giacomogramaglia/digital_synth/README.md

# digital_synth
FPGA-based digital audio synthesizer board

Contains
- Schematics
- FPGA RTL files / Quartus II project
- KiCad project
- PCB production files
