giacomogramaglia/digital_synth/Project_Schematic.pdf

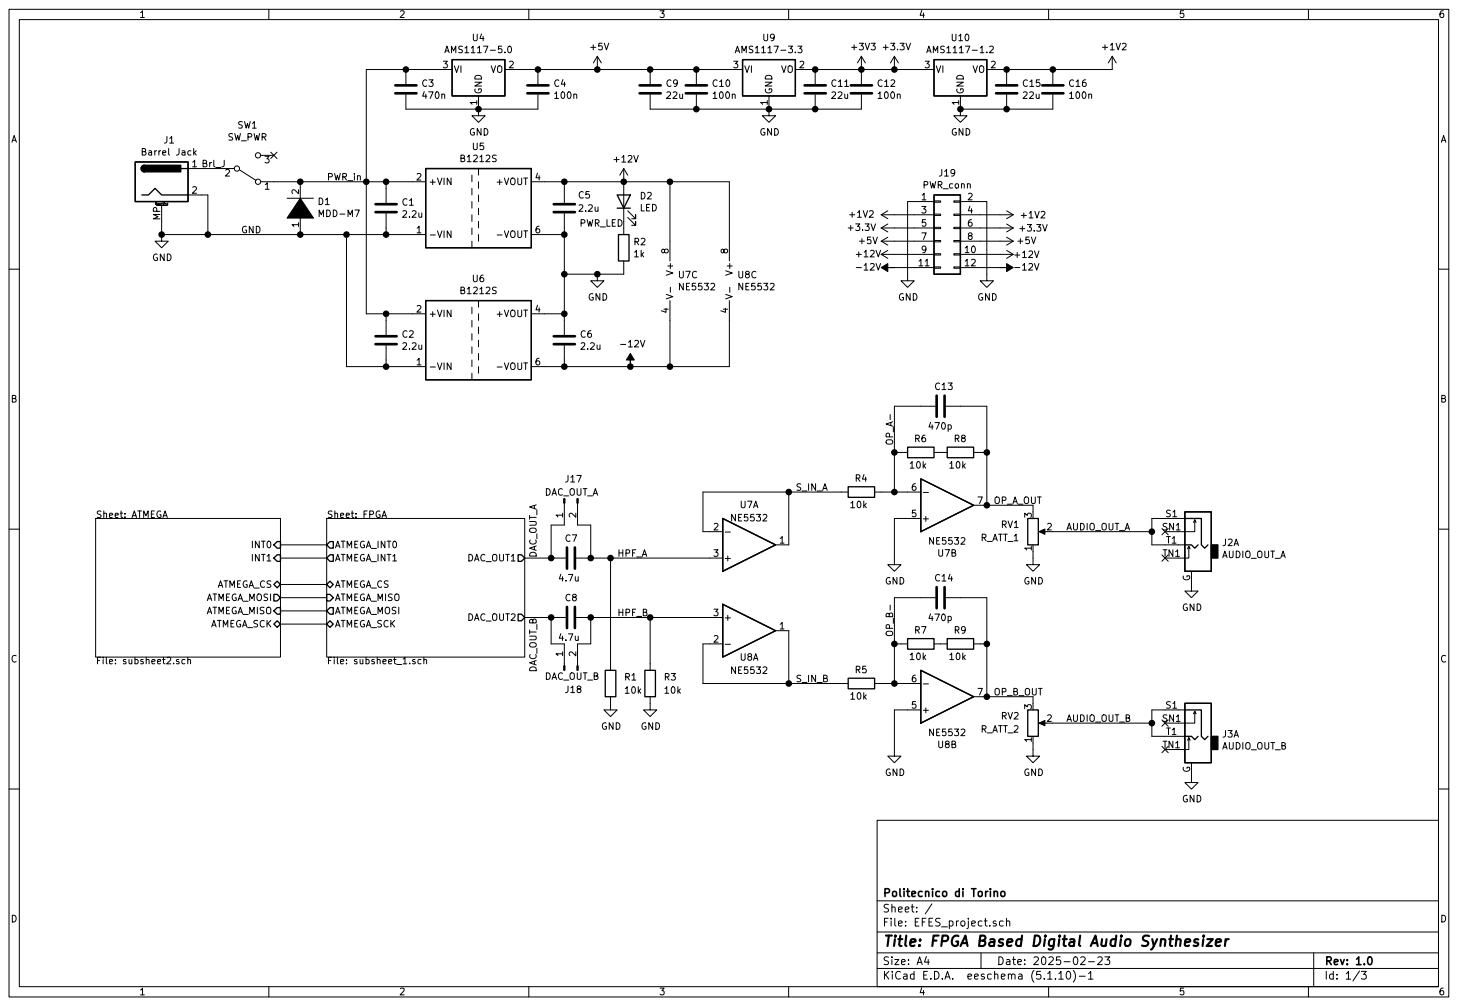
[picture p1: page 1]

File: EFES_project.sch Sheet: / Politecnico di Torino

Id: 1/3 Title: FPGA Based Digital Audio Synthesizer

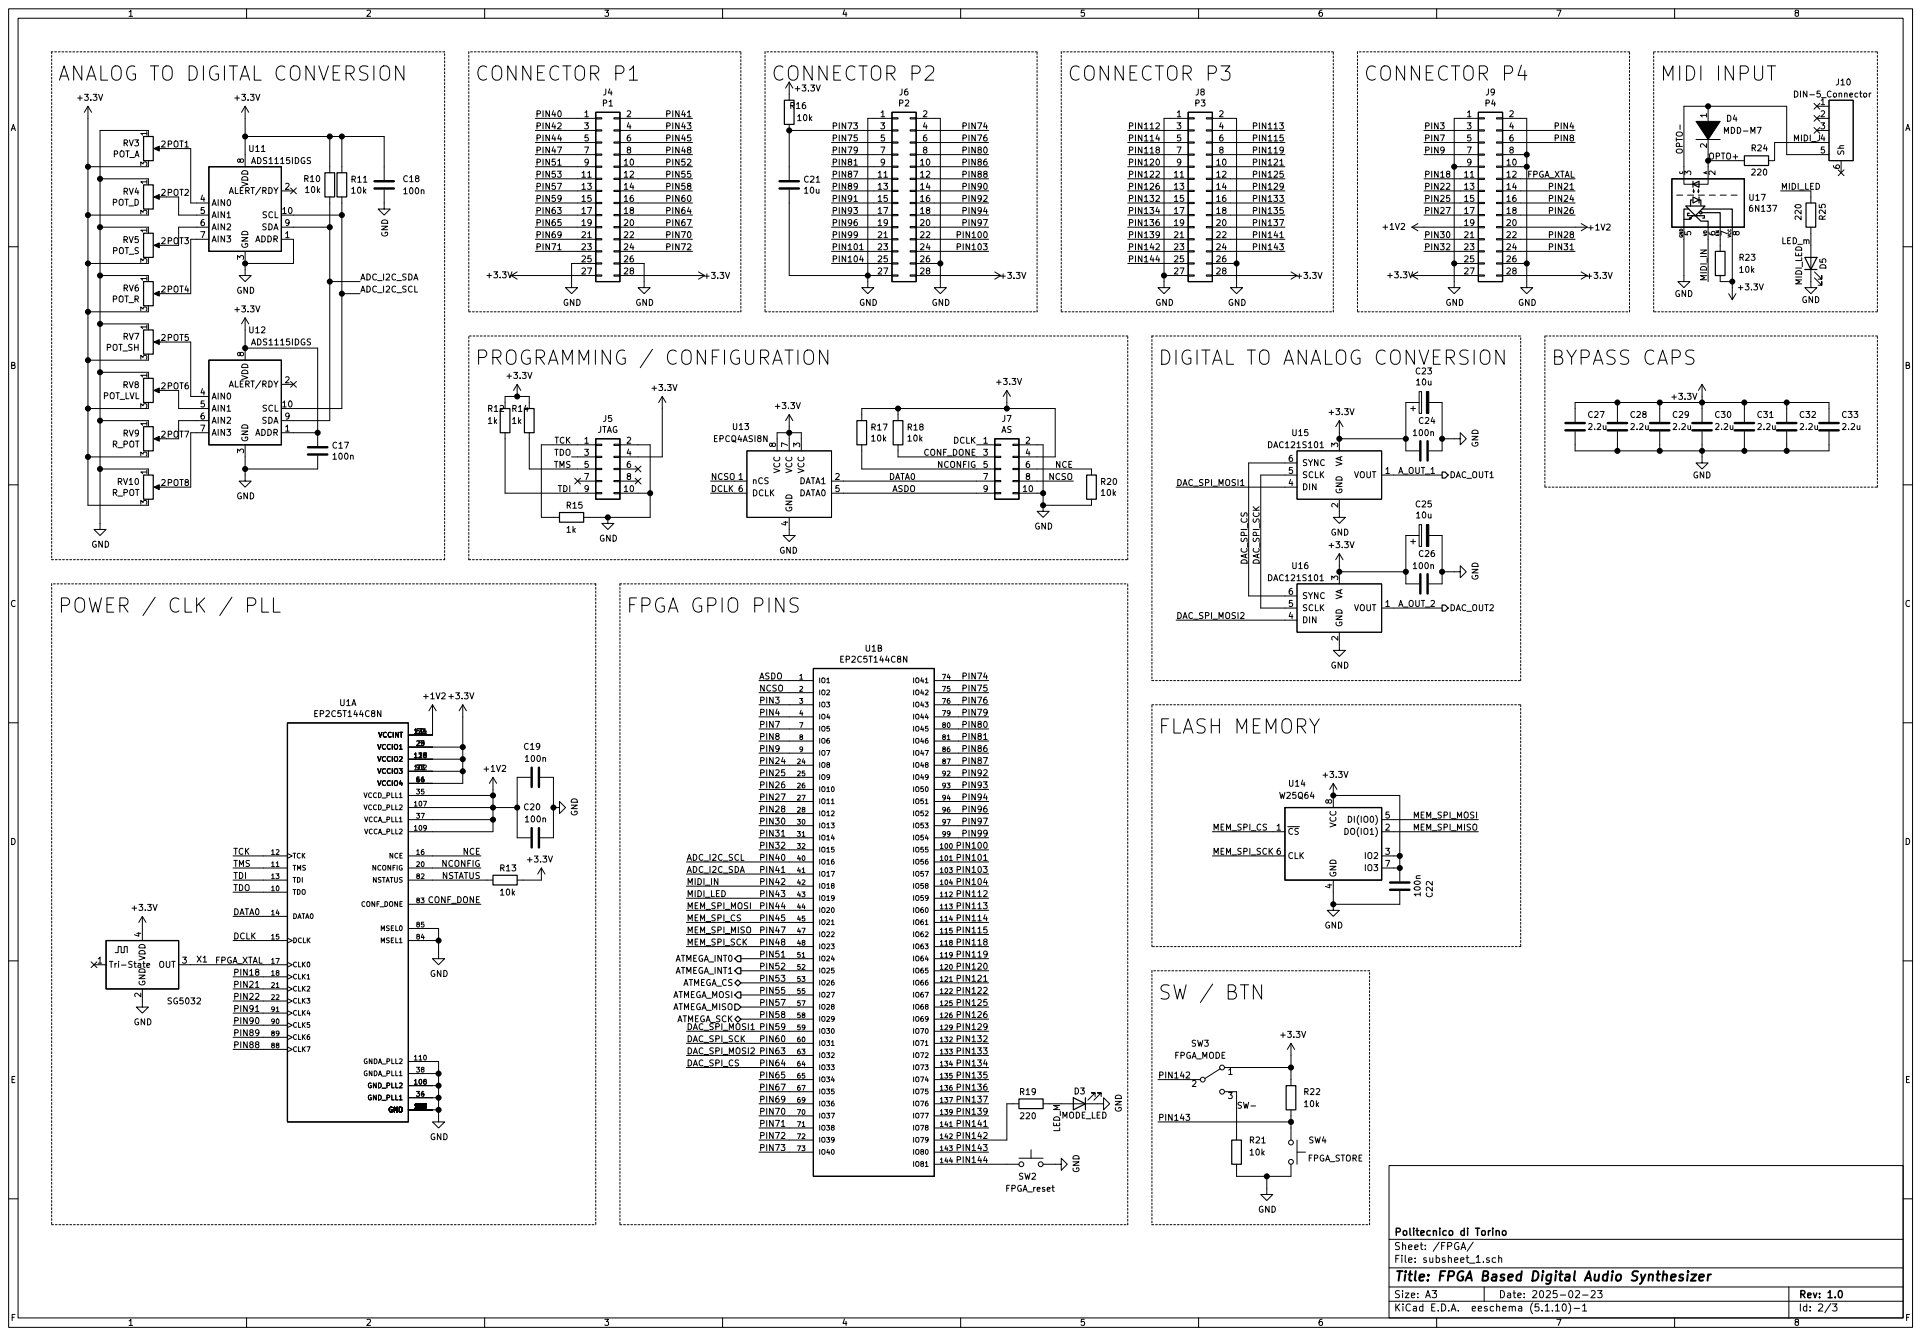
[picture p2: page 2]

PIN104 PIN76 PIN74 PIN27 ANALOG TO DIGITAL CONVERSION

DIGITAL TO ANALOG CONVERSION

3 DIN 4 SCLK 5 SYNC 6U16 DAC121S101 GND GND

File: subsheet_1.sch Sheet: /FPGA/ Politecnico di Torino

Id: 2/3 Title: FPGA Based Digital Audio Synthesizer

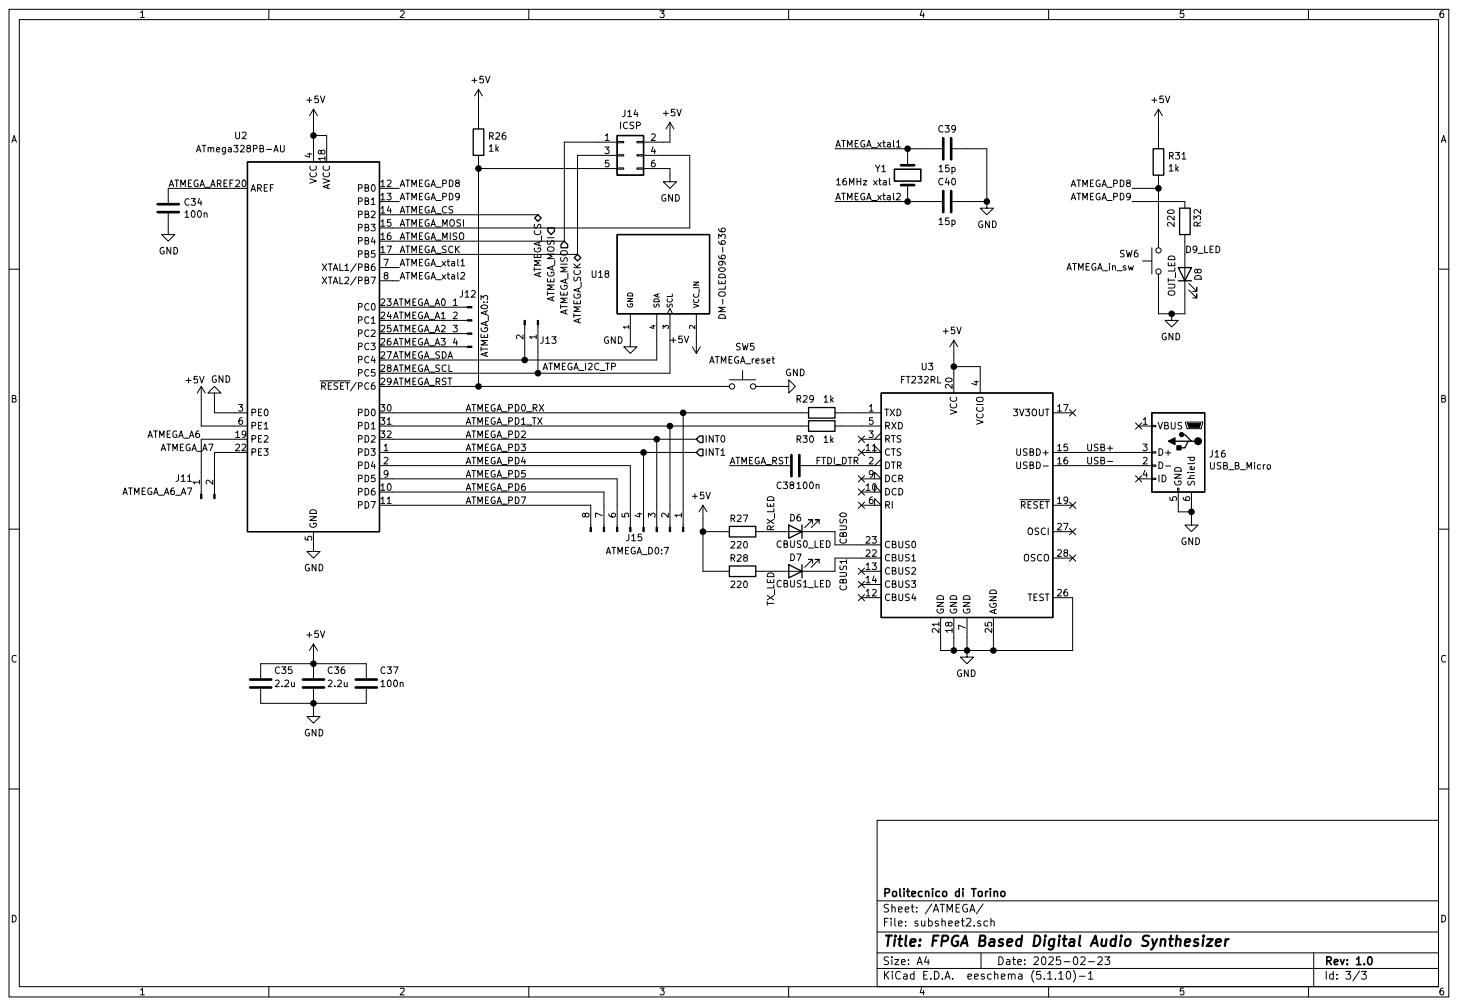
[picture p3: page 3]

1 U18 DM-OLED096-636 TXD 1 DCD 10 CTS 11 CBUS4 12 CBUS2 13 CBUS3 14 USBD+ 15 USBD- 16

Id: 3/3 Title: FPGA Based Digital Audio Synthesizer File: subsheet2.sch Sheet: /ATMEGA/ Politecnico di Torino
