giacomogramaglia/digital_synth/KiCad/EFES_project.kicad_pcb

## KiCad design KiCad/EFES_project.kicad_pcb (2026-01-29)

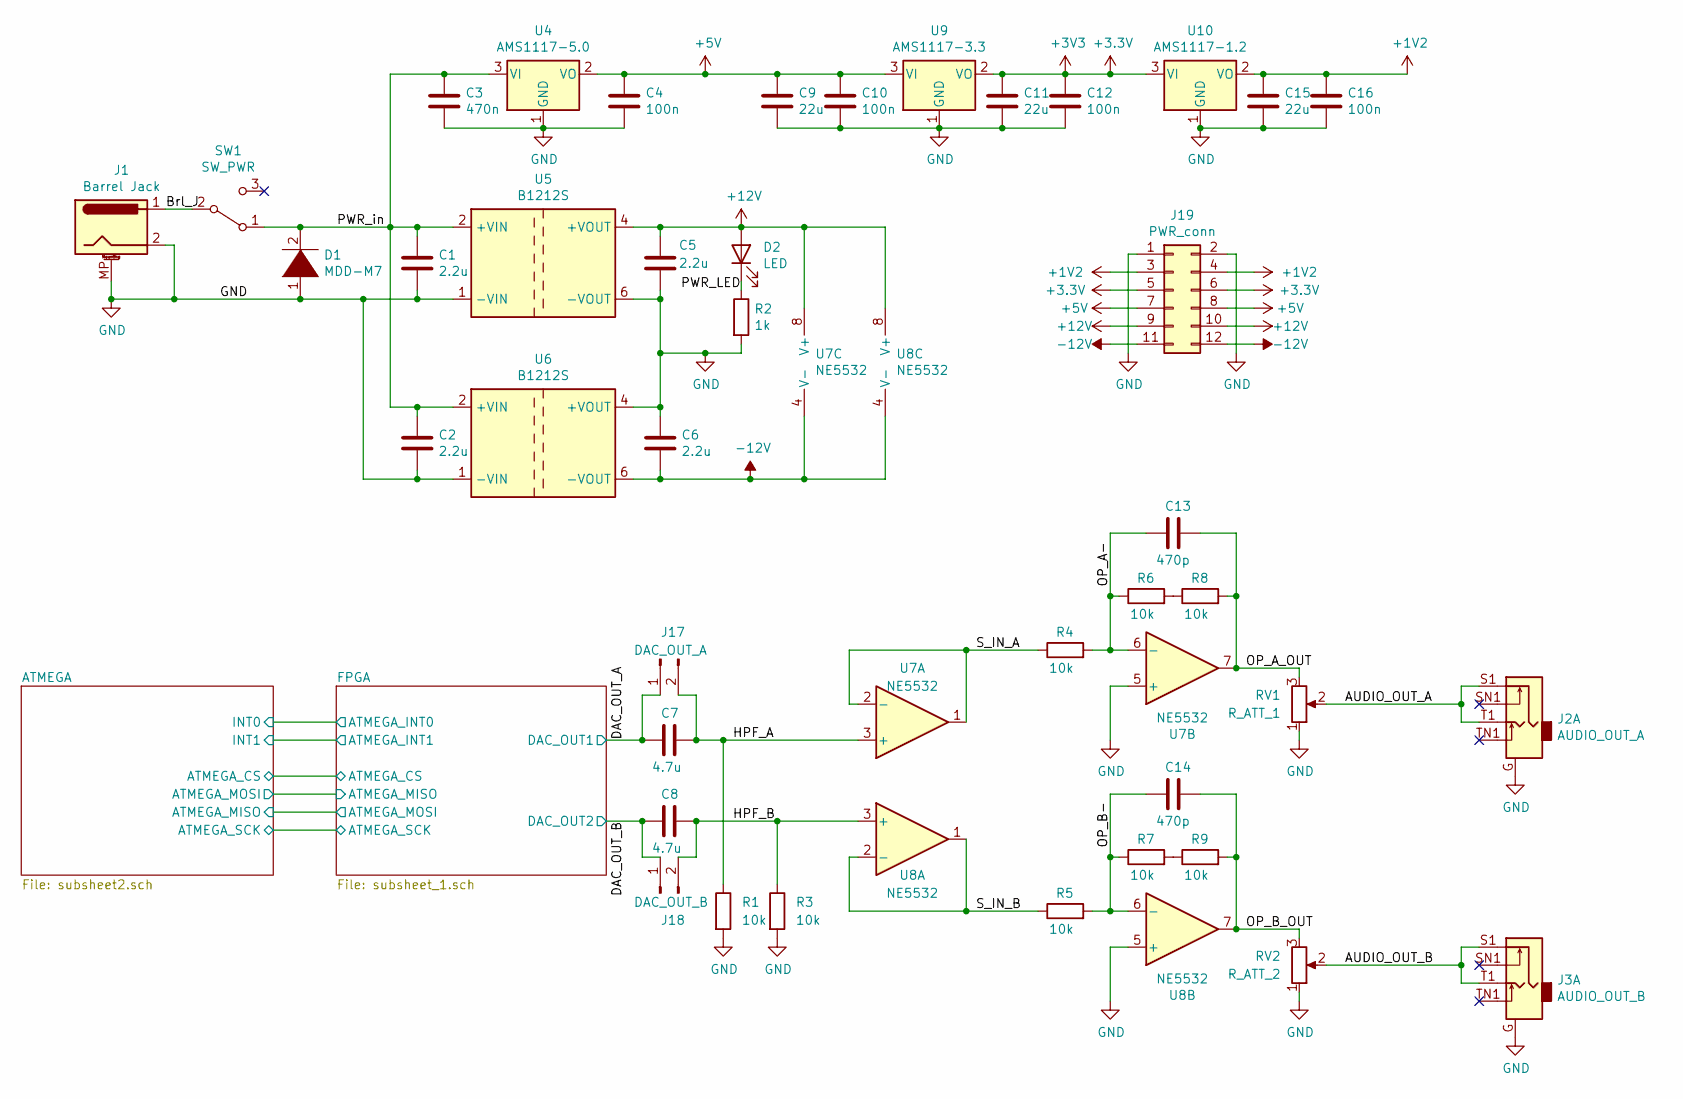
[picture p4: schematic EFES_project.sch, FPGA Based Digital Audio Synthesizer]

Parts:
C1, C2, C5, C6: 2.2u; C_0805_2012Metric
C3: 470n; C_0603_1608Metric
C4, C10, C12, C16: 100n; C_0402_1005Metric
C7, C8: 4.7u; C_0805_2012Metric
C9, C11, C15: 22u; C_0805_2012Metric
C13, C14: 470p; C_0805_2012Metric
D1: MDD-M7; D_SMA
D2: LED; LED_0805_2012Metric
J1: Barrel Jack; BarrelJack_Horizontal
J2: AUDIO_OUT_A; PJ-307
J3: AUDIO_OUT_B; PJ-307
J17: DAC_OUT_A; PinHeader_1x02_P2.54mm_Vertical
J18: DAC_OUT_B; PinHeader_1x02_P2.54mm_Vertical
J19: PWR_conn; PinHeader_2x06_P2.54mm_Vertical
R1, R3, R4, R5, R6, R7, R8, R9: 10k; R_0402_1005Metric
R2: 1k; R_1206_3216Metric
RV1: R_ATT_1; Potentiometer_Alpha_RD901F-40-00D_Single_Vertical
RV2: R_ATT_2; Potentiometer_Alpha_RD901F-40-00D_Single_Vertical
SW1: SW_PWR; MTS-103
U4: AMS1117-5.0; SOT-223-3_TabPin2
U5, U6: B1212S; Converter_DCDC_muRata_CRE1xxxxxxSC_THT
U7: NE5532; SOIC-8-1EP_3.9x4.9mm_P1.27mm_EP2.29x3mm
U8: NE5532
U9: AMS1117-3.3; SOT-223-3_TabPin2
U10: AMS1117-1.2; SOT-223-3_TabPin2

Connections:
+1V2: C15.1, C16.1, J19.3, J19.4, U10.2 (VO); also elsewhere on the board
+3V3: C11.1, C12.1, J19.5, J19.6, U9.2 (VO), U10.3 (VI); also elsewhere on the board
+5V: C4.1, C9.1, C10.1, J19.7, J19.8, U4.2 (VO), U9.3 (VI); also elsewhere on the board
-12V: C6.2, J19.11, J19.12, U6.3, U6.6 (-VOUT), U7.4 (V-), U8.4 (V-)
/AUDIO_OUT_A: J2.2, J2.3, J2.4, J2.5, J2.S1, J2.T1, RV1.2
/AUDIO_OUT_B: J3.2, J3.3, J3.4, J3.5, J3.S1, J3.T1, RV2.2
/Brl_J: J1.1, SW1.2 (B)
/DAC_OUT_A: C7.2, J17.1; also elsewhere on the board
/DAC_OUT_B: C8.2, J18.1; also elsewhere on the board
/HPF_A: C7.1, J17.2, R1.1, U7.3 (+)
/HPF_B: C8.1, J18.2, R3.1, U8.3 (+)
/OP_A-: C13.2, R4.2, R6.1, U7.6 (-)
/OP_A_OUT: C13.1, R8.2, RV1.3, U7.7
/OP_B-: C14.2, R5.2, R7.1, U8.6 (-)
/OP_B_OUT: C14.1, R9.2, RV2.3, U8.7
/PWR_LED: D2.1 (K), R2.1
/S_IN_A: R4.1, U7.1, U7.2 (-)
/S_IN_B: R5.1, U8.1, U8.2 (-)
GND: C1.2, C2.2, C3.2, C4.2, C5.2, C6.1, C9.2, C10.2, C11.2, C12.2, C15.2, C16.2, D1.1 (K), J1.2, J1.MP (MountPin), J2.1, J2.G, J3.1, J3.G, J19.1, J19.2, R1.2, R2.2, R3.2, RV1.1, RV2.1, U4.1 (GND), U5.1 (-VIN), U5.3, U5.6 (-VOUT), U6.1 (-VIN), U6.4 (+VOUT), U7.5 (+), U8.5 (+), U9.1 (GND), U10.1 (GND); also elsewhere on the board
unnamed: R6.2, R8.1
unnamed: R7.2, R9.1

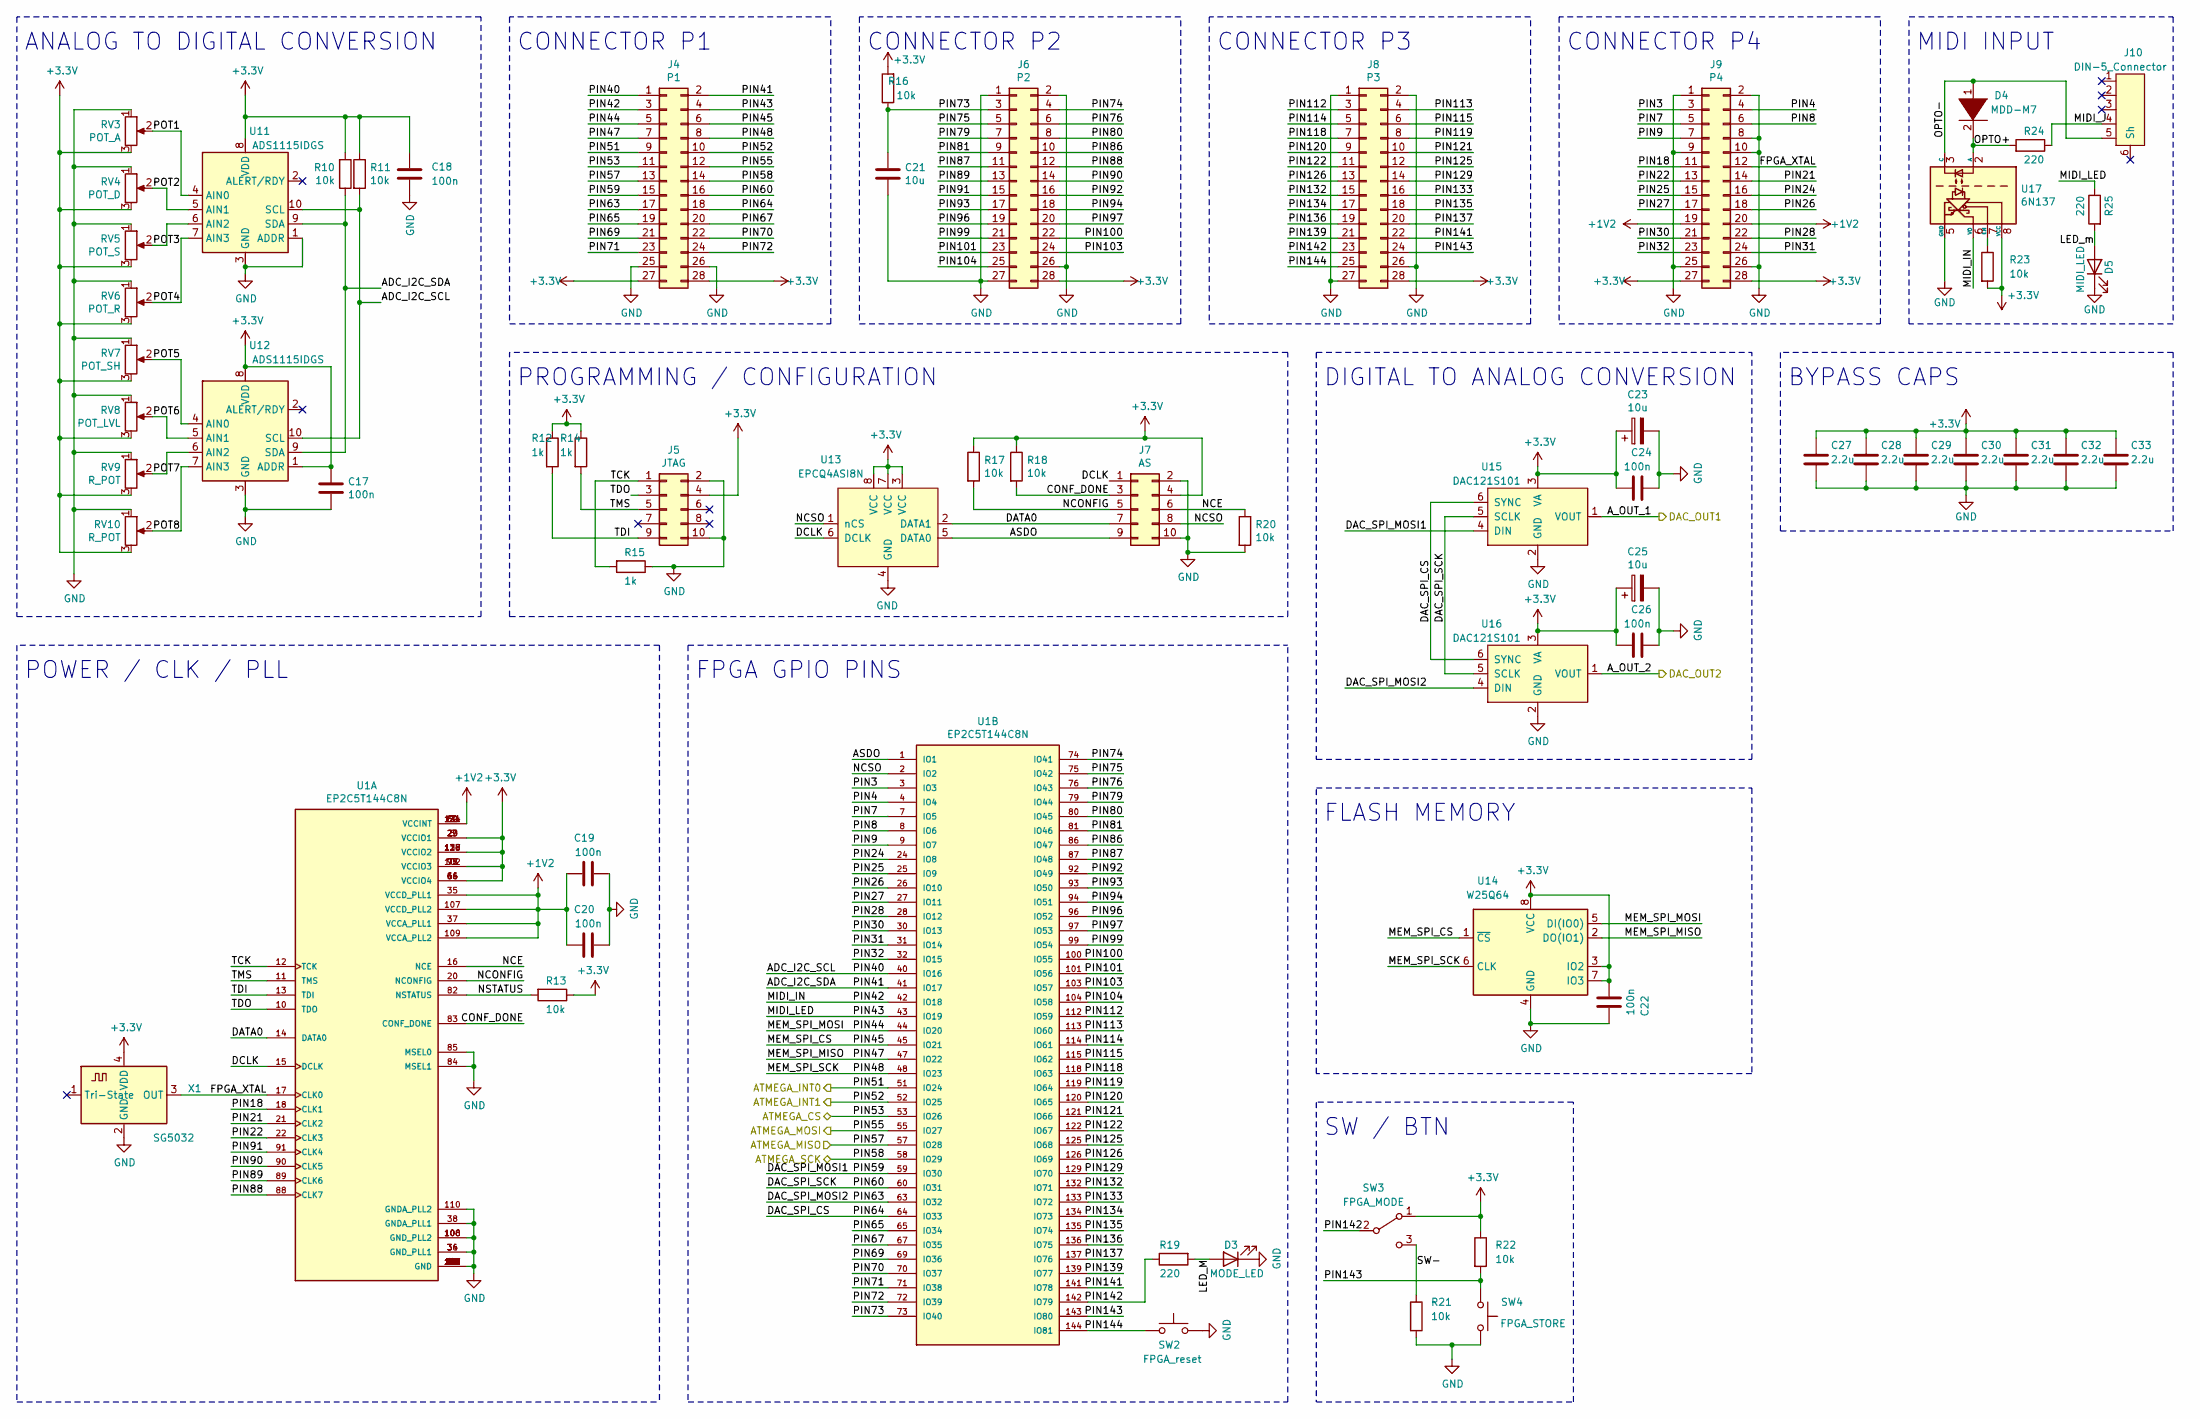
[picture p5: schematic subsheet_1.sch, FPGA Based Digital Audio Synthesizer]

Parts:
C17, C18, C19, C20, C22, C24, C26: 100n; C_0402_1005Metric
C21: 10u; C_1206_3216Metric
C23, C25: 10u; CP_EIA-3216-18_Kemet-A
C27, C28, C29, C30, C31, C32, C33: 2.2u; C_0805_2012Metric
D3: MODE_LED; LED_0805_2012Metric
D4: MDD-M7; D_SMA
D5: MIDI_LED; LED_0805_2012Metric
J4: P1; PinHeader_2x14_P2.54mm_Vertical
J5: JTAG; IDC-Header_2x05_P2.54mm_Vertical
J6: P2; PinHeader_2x14_P2.54mm_Vertical
J7: AS; IDC-Header_2x05_P2.54mm_Vertical
J8: P3; PinHeader_2x14_P2.54mm_Vertical
J9: P4; PinHeader_2x14_P2.54mm_Vertical
J10: DIN-5_Connector; DIN-504-M10
R10, R11, R13, R16, R17, R18, R20, R21, R22, R23: 10k; R_0402_1005Metric
R12, R14, R15: 1k; R_0603_1608Metric
R19, R24, R25: 220; R_0805_2012Metric
RV3: POT_A; Potentiometer_Alpha_RD901F-40-00D_Single_Vertical
RV4: POT_D; Potentiometer_Alpha_RD901F-40-00D_Single_Vertical
RV5: POT_S; Potentiometer_Alpha_RD901F-40-00D_Single_Vertical
RV6: POT_R; Potentiometer_Alpha_RD901F-40-00D_Single_Vertical
RV7: POT_SH; Potentiometer_Alpha_RD901F-40-00D_Single_Vertical
RV8: POT_LVL; Potentiometer_Alpha_RD901F-40-00D_Single_Vertical
RV9, RV10: R_POT; Potentiometer_Alpha_RD901F-40-00D_Single_Vertical
SW2: FPGA_reset; SW_Push_1P1T_NO_6x6mm_H9.5mm
SW3: FPGA_MODE; MTS-103
SW4: FPGA_STORE; SW_Push_1P1T_NO_6x6mm_H9.5mm
U1: EP2C5T144C8N; QFP50P2200X2200X160-144N
U11, U12: ADS1115IDGS; TSSOP-10_3x3mm_P0.5mm
U13: EPCQ4ASI8N; SOIC-8_3.9x4.9mm_P1.27mm
U14: W25Q64; SOIC-8_5.23x5.23mm_P1.27mm
U15, U16: DAC121S101; SOT-23-6
U17: 6N137; SOP-8_6.62x9.15mm_P2.54mm
X1: SG5032; Crystal_SMD_5032-4Pin_5.0x3.2mm

Connections:
+1V2: C19.1, C20.1, J9.19, J9.20, U1.35 (VCCD_PLL1), U1.37 (VCCA_PLL1), U1.50 (VCCINT), U1.62 (VCCINT), U1.107 (VCCD_PLL2), U1.109 (VCCA_PLL2), U1.124 (VCCINT), U1.131 (VCCINT); also elsewhere on the board
+3V3: C17.1, C18.1, C22.2, C23.1, C24.2, C25.1, C26.2, C27.1, C28.1, C29.1, C30.1, C31.1, C32.1, C33.1, J4.27, J4.28, J5.4, J6.28, J7.4, J8.28, J9.27, J9.28, R10.2, R11.1, R12.1, R13.1, R14.1, R16.2, R17.1, R18.1, R22.1, R23.2, RV3.3, RV4.3, RV5.3, RV6.3, RV7.3, RV8.3, RV9.3, RV10.3, SW3.1 (A), U1.5 (VCCIO1), U1.23 (VCCIO1), U1.29 (VCCIO1), U1.46 (VCCIO4), U1.54 (VCCIO4), U1.66 (VCCIO4), U1.77 (VCCIO3), U1.95 (VCCIO3), U1.102 (VCCIO3), U1.116 (VCCIO2), U1.127 (VCCIO2), U1.138 (VCCIO2), U11.8 (VDD), U12.1 (ADDR), U12.8 (VDD), U13.3 (VCC), U13.7 (VCC), U13.8 (VCC), U14.3 (IO2), U14.7 (IO3), U14.8 (VCC), U15.3 (VA), U16.3 (VA), U17.8 (VCC), X1.4 (VDD); also elsewhere on the board
/ATMEGA/ATMEGA_CS: J4.11, U1.53 (IO26); also elsewhere on the board
/ATMEGA/ATMEGA_MISO: J4.12, U1.55 (IO27); also elsewhere on the board
/ATMEGA/ATMEGA_SCK: J4.14, U1.58 (IO29); also elsewhere on the board
/DAC_OUT_A: U15.1 (VOUT); also elsewhere on the board
/DAC_OUT_B: U16.1 (VOUT); also elsewhere on the board
/FPGA/ADC_I2C_SCL: J4.1, R11.2, U1.40 (IO16), U11.10 (SCL), U12.10 (SCL)
/FPGA/ADC_I2C_SDA: J4.2, R10.1, U1.41 (IO17), U11.9 (SDA), U12.9 (SDA)
/FPGA/ASDO: J7.9, U1.1 (IO1), U13.5 (DATA0)
/FPGA/ATMEGA_INT0: J4.9, U1.51 (IO24); also elsewhere on the board
/FPGA/ATMEGA_INT1: J4.10, U1.52 (IO25); also elsewhere on the board
/FPGA/ATMEGA_MISO: J4.13, U1.57 (IO28); also elsewhere on the board
/FPGA/CONF_DONE: J7.3, R18.2, U1.83 (CONF_DONE)
/FPGA/DAC_SPI_CS: J4.18, U1.64 (IO33), U15.6 (SYNC), U16.6 (SYNC)
/FPGA/DAC_SPI_MOSI1: J4.15, U1.59 (IO30), U15.4 (DIN)
/FPGA/DAC_SPI_MOSI2: J4.17, U1.63 (IO32), U16.4 (DIN)
/FPGA/DAC_SPI_SCK: J4.16, U1.60 (IO31), U15.5 (SCLK), U16.5 (SCLK)
/FPGA/DATA0: J7.7, U1.14 (DATA0), U13.2 (DATA1)
/FPGA/DCLK: J7.1, U1.15 (DCLK), U13.6 (DCLK)
/FPGA/FPGA_XTAL: J9.12, U1.17 (CLK0), X1.3 (OUT)
/FPGA/LED_M: D3.2 (A), R19.2
/FPGA/LED_m: D5.2 (A), R25.2
/FPGA/MEM_SPI_CS: J4.6, U1.45 (IO21), U14.1 (~CS)
/FPGA/MEM_SPI_MISO: J4.7, U1.47 (IO22), U14.2 (DO(IO1))
/FPGA/MEM_SPI_MOSI: J4.5, U1.44 (IO20), U14.5 (DI(IO0))
/FPGA/MEM_SPI_SCK: J4.8, U1.48 (IO23), U14.6 (CLK)
/FPGA/MIDI_IN: J4.3, U1.42 (IO18), U17.6 (VO)
/FPGA/MIDI_J: J10.4, R24.1
/FPGA/MIDI_LED: J4.4, R25.1, U1.43 (IO19)
/FPGA/NCE: J7.6, R20.1, U1.16 (NCE)
/FPGA/NCONFIG: J7.5, R17.2, U1.20 (NCONFIG)
/FPGA/NCSO: J7.8, U1.2 (IO2), U13.1 (nCS)
/FPGA/NSTATUS: R13.2, U1.82 (NSTATUS)
/FPGA/OPTO+: D4.2 (A), R24.2, U17.2 (A)
/FPGA/OPTO-: D4.1 (K), J10.5, U17.3 (C)
/FPGA/PIN3: J9.3, U1.3 (IO3)
/FPGA/PIN4: J9.4, U1.4 (IO4)
/FPGA/PIN7: J9.5, U1.7 (IO5)
/FPGA/PIN8: J9.6, U1.8 (IO6)
/FPGA/PIN9: J9.7, U1.9 (IO7)
/FPGA/PIN18: J9.11, U1.18 (CLK1)
/FPGA/PIN21: J9.14, U1.21 (CLK2)
/FPGA/PIN22: J9.13, U1.22 (CLK3)
/FPGA/PIN24: J9.16, U1.24 (IO8)
/FPGA/PIN25: J9.15, U1.25 (IO9)
/FPGA/PIN26: J9.18, U1.26 (IO10)
/FPGA/PIN27: J9.17, U1.27 (IO11)
/FPGA/PIN28: J9.22, U1.28 (IO12)
/FPGA/PIN30: J9.21, U1.30 (IO13)
/FPGA/PIN31: J9.24, U1.31 (IO14)
/FPGA/PIN32: J9.23, U1.32 (IO15)
/FPGA/PIN65: J4.19, U1.65 (IO34)
/FPGA/PIN67: J4.20, U1.67 (IO35)
/FPGA/PIN69: J4.21, U1.69 (IO36)
/FPGA/PIN70: J4.22, U1.70 (IO37)
/FPGA/PIN71: J4.23, U1.71 (IO38)
/FPGA/PIN72: J4.24, U1.72 (IO39)
/FPGA/PIN73: C21.1, J6.3, R16.1, U1.73 (IO40)
/FPGA/PIN74: J6.4, U1.74 (IO41)
/FPGA/PIN75: J6.5, U1.75 (IO42)
/FPGA/PIN76: J6.6, U1.76 (IO43)
/FPGA/PIN79: J6.7, U1.79 (IO44)
/FPGA/PIN80: J6.8, U1.80 (IO45)
/FPGA/PIN81: J6.9, U1.81 (IO46)
/FPGA/PIN86: J6.10, U1.86 (IO47)
/FPGA/PIN87: J6.11, U1.87 (IO48)
/FPGA/PIN88: J6.12, U1.88 (CLK7)
/FPGA/PIN89: J6.13, U1.89 (CLK6)
/FPGA/PIN90: J6.14, U1.90 (CLK5)
/FPGA/PIN91: J6.15, U1.91 (CLK4)
/FPGA/PIN92: J6.16, U1.92 (IO49)
/FPGA/PIN93: J6.17, U1.93 (IO50)
/FPGA/PIN94: J6.18, U1.94 (IO51)
/FPGA/PIN96: J6.19, U1.96 (IO52)
/FPGA/PIN97: J6.20, U1.97 (IO53)
/FPGA/PIN99: J6.21, U1.99 (IO54)
/FPGA/PIN100: J6.22, U1.100 (IO55)
/FPGA/PIN101: J6.23, U1.101 (IO56)
/FPGA/PIN103: J6.24, U1.103 (IO57)
/FPGA/PIN104: J6.25, U1.104 (IO58)
/FPGA/PIN112: J8.3, U1.112 (IO59)
/FPGA/PIN113: J8.4, U1.113 (IO60)
/FPGA/PIN114: J8.5, U1.114 (IO61)
/FPGA/PIN115: J8.6, U1.115 (IO62)
/FPGA/PIN118: J8.7, U1.118 (IO63)
/FPGA/PIN119: J8.8, U1.119 (IO64)
/FPGA/PIN120: J8.9, U1.120 (IO65)
/FPGA/PIN121: J8.10, U1.121 (IO66)
/FPGA/PIN122: J8.11, U1.122 (IO67)
/FPGA/PIN125: J8.12, U1.125 (IO68)
/FPGA/PIN126: J8.13, U1.126 (IO69)
/FPGA/PIN129: J8.14, U1.129 (IO70)
/FPGA/PIN132: J8.15, U1.132 (IO71)
/FPGA/PIN133: J8.16, U1.133 (IO72)
/FPGA/PIN134: J8.17, U1.134 (IO73)
/FPGA/PIN135: J8.18, U1.135 (IO74)
/FPGA/PIN136: J8.19, U1.136 (IO75)
/FPGA/PIN137: J8.20, U1.137 (IO76)
/FPGA/PIN139: J8.21, U1.139 (IO77)
/FPGA/PIN141: J8.22, U1.141 (IO78)
/FPGA/PIN142: J8.23, R19.1, SW3.2 (B), U1.142 (IO79)
/FPGA/PIN143: J8.24, R22.2, SW4.1, U1.143 (IO80)
/FPGA/PIN144: J8.25, SW2.1, U1.144 (IO81)
/FPGA/POT1: RV3.2, U11.4 (AIN0)
/FPGA/POT2: RV4.2, U11.5 (AIN1)
/FPGA/POT3: RV5.2, U11.6 (AIN2)
/FPGA/POT4: RV6.2, U11.7 (AIN3)
/FPGA/POT5: RV7.2, U12.4 (AIN0)
/FPGA/POT6: RV8.2, U12.5 (AIN1)
/FPGA/POT7: RV9.2, U12.6 (AIN2)
/FPGA/POT8: RV10.2, U12.7 (AIN3)
/FPGA/SW-: R21.1, SW3.3 (C)
/FPGA/TCK: J5.1, R15.2, U1.12 (TCK)
/FPGA/TDI: J5.9, R12.2, U1.13 (TDI)
/FPGA/TDO: J5.3, U1.10 (TDO)
/FPGA/TMS: J5.5, R14.2, U1.11 (TMS)
GND: C17.2, C18.2, C19.2, C20.2, C21.2, C22.1, C23.2, C24.1, C25.2, C26.1, C27.2, C28.2, C29.2, C30.2, C31.2, C32.2, C33.2, D3.1 (K), D5.1 (K), J4.25, J4.26, J5.2, J5.10, J6.1, J6.2, J6.26, J6.27, J7.2, J7.10, J8.1, J8.2, J8.26, J8.27, J9.1, J9.2, J9.8, J9.9, J9.10, J9.25, J9.26, R15.1, R20.2, R21.2, RV3.1, RV4.1, RV5.1, RV6.1, RV7.1, RV8.1, RV9.1, RV10.1, SW2.2, SW4.2, U1.6 (GND), U1.19 (GND), U1.33 (GND), U1.34 (GND_PLL1), U1.36 (GND_PLL1), U1.38 (GNDA_PLL1), U1.39 (GND), U1.49 (GND), U1.56 (GND), U1.61 (GND), U1.68 (GND), U1.78 (GND), U1.84 (MSEL1), U1.85 (MSEL0), U1.98 (GND), U1.105 (GND), U1.106 (GND_PLL2), U1.108 (GND_PLL2), U1.110 (GNDA_PLL2), U1.111 (GND), U1.117 (GND), U1.123 (GND), U1.128 (GND), U1.130 (GND), U1.140 (GND), U11.1 (ADDR), U11.3 (GND), U12.3 (GND), U13.4 (GND), U14.4 (GND), U15.2 (GND), U16.2 (GND), U17.5 (GND), X1.2 (GND); also elsewhere on the board
unnamed: R23.1, U17.7 (EN)

Notes on the sheet:
ANALOG TO DIGITAL CONVERSION
PROGRAMMING / CONFIGURATION
POWER / CLK / PLL
CONNECTOR P4
CONNECTOR P3
CONNECTOR P2
CONNECTOR P1
FPGA GPIO PINS
DIGITAL TO ANALOG CONVERSION
FLASH MEMORY
MIDI INPUT
SW / BTN
BYPASS CAPS

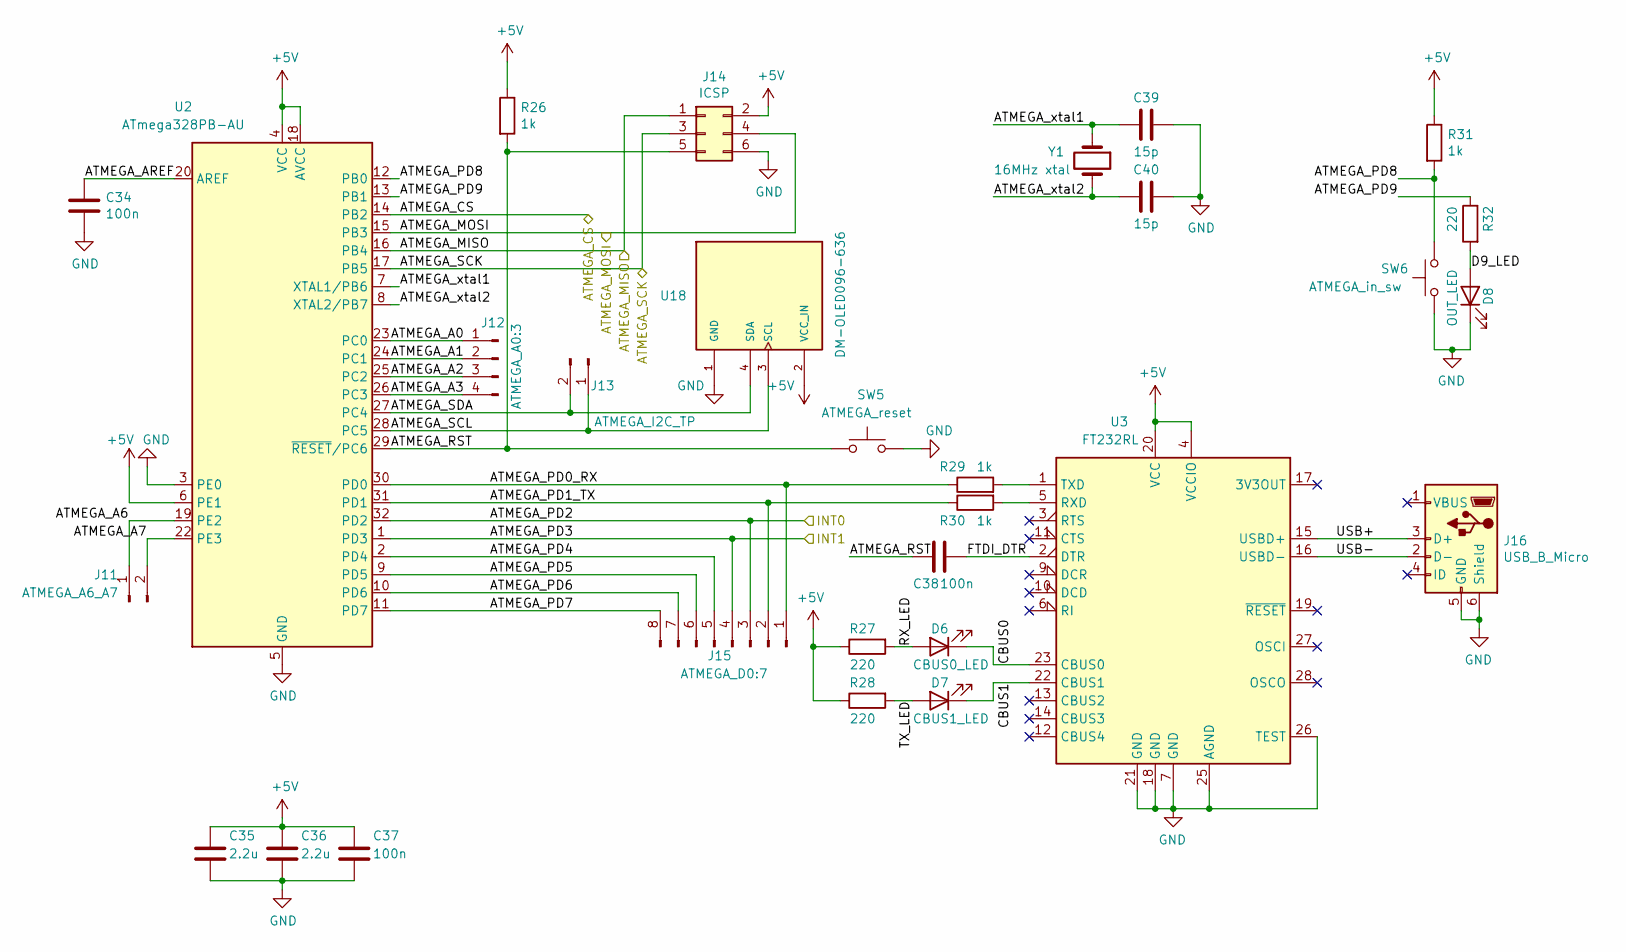
[picture p6: schematic subsheet2.sch, FPGA Based Digital Audio Synthesizer]

Parts:
C34, C37, C38: 100n; C_0402_1005Metric
C35, C36: 2.2u; C_0805_2012Metric
C39, C40: 15p; C_0603_1608Metric
D6: CBUS0_LED; LED_0805_2012Metric
D7: CBUS1_LED; LED_0805_2012Metric
D8: OUT_LED; LED_0805_2012Metric
J11: ATMEGA_A6_A7; PinHeader_1x02_P2.54mm_Vertical
J12: ATMEGA_A0:3; PinHeader_1x04_P2.54mm_Vertical
J13: ATMEGA_I2C_TP; PinHeader_1x02_P2.54mm_Vertical
J14: ICSP; PinHeader_2x03_P1.00mm_Vertical
J15: ATMEGA_D0:7; PinHeader_1x08_P2.54mm_Vertical
J16: USB_B_Micro; USB_Micro-B_Amphenol_10103594-0001LF_Horizontal
R26, R29, R30, R31: 1k; R_0603_1608Metric
R27, R28, R32: 220; R_0805_2012Metric
SW5: ATMEGA_reset; SW_Push_1P1T_NO_6x6mm_H9.5mm
SW6: ATMEGA_in_sw; SW_Push_1P1T_NO_6x6mm_H9.5mm
U2: ATmega328PB-AU; TQFP-32_7x7mm_P0.8mm
U3: FT232RL; SSOP-28_5.3x10.2mm_P0.65mm
U18: DM-OLED096-636; MODULE_DM-OLED096-636; PARTREV 2018-09-10
Y1: 16MHz xtal; Crystal_HC18-U_Vertical

Connections:
+5V: C35.1, C36.1, C37.1, J14.2, R26.1, R27.1, R28.1, R31.1, U2.4 (VCC), U2.6 (PE1), U2.18 (AVCC), U3.4 (VCCIO), U3.20 (VCC), U18.2 (VCC_IN); also elsewhere on the board
/ATMEGA/ATMEGA_A0: J12.1, U2.23 (PC0)
/ATMEGA/ATMEGA_A1: J12.2, U2.24 (PC1)
/ATMEGA/ATMEGA_A2: J12.3, U2.25 (PC2)
/ATMEGA/ATMEGA_A3: J12.4, U2.26 (PC3)
/ATMEGA/ATMEGA_A6: J11.1, U2.19 (PE2)
/ATMEGA/ATMEGA_A7: J11.2, U2.22 (PE3)
/ATMEGA/ATMEGA_AREF: C34.1, U2.20 (AREF)
/ATMEGA/ATMEGA_CS: U2.14 (PB2); also elsewhere on the board
/ATMEGA/ATMEGA_MISO: J14.1, U2.16 (PB4); also elsewhere on the board
/ATMEGA/ATMEGA_PD0_RX: J15.1, R29.1, U2.30 (PD0)
/ATMEGA/ATMEGA_PD1_TX: J15.2, R30.1, U2.31 (PD1)
/ATMEGA/ATMEGA_PD4: J15.5, U2.2 (PD4)
/ATMEGA/ATMEGA_PD5: J15.6, U2.9 (PD5)
/ATMEGA/ATMEGA_PD6: J15.7, U2.10 (PD6)
/ATMEGA/ATMEGA_PD7: J15.8, U2.11 (PD7)
/ATMEGA/ATMEGA_PD8: R31.2, SW6.2, U2.12 (PB0)
/ATMEGA/ATMEGA_PD9: R32.1, U2.13 (PB1)
/ATMEGA/ATMEGA_RST: C38.2, J14.5, R26.2, SW5.1, U2.29 (~RESET~/PC6)
/ATMEGA/ATMEGA_SCK: J14.3, U2.17 (PB5); also elsewhere on the board
/ATMEGA/ATMEGA_SCL: J13.1, U2.28 (PC5), U18.3 (SCL)
/ATMEGA/ATMEGA_SDA: J13.2, U2.27 (PC4), U18.4 (SDA)
/ATMEGA/ATMEGA_xtal1: C39.2, U2.7 (XTAL1/PB6), Y1.1
/ATMEGA/ATMEGA_xtal2: C40.2, U2.8 (XTAL2/PB7), Y1.2
/ATMEGA/CBUS0: D6.1 (K), U3.23 (CBUS0)
/ATMEGA/CBUS1: D7.1 (K), U3.22 (CBUS1)
/ATMEGA/D9_LED: D8.2 (A), R32.2
/ATMEGA/FTDI_DTR: C38.1, U3.2 (DTR)
/ATMEGA/RX_LED: D6.2 (A), R27.2
/ATMEGA/TX_LED: D7.2 (A), R28.2
/ATMEGA/USB+: J16.3 (D+), U3.15 (USBD+)
/ATMEGA/USB-: J16.2 (D-), U3.16 (USBD-)
/FPGA/ATMEGA_INT0: J15.3, U2.32 (PD2); also elsewhere on the board
/FPGA/ATMEGA_INT1: J15.4, U2.1 (PD3); also elsewhere on the board
/FPGA/ATMEGA_MISO: J14.4, U2.15 (PB3); also elsewhere on the board
GND: C34.2, C35.2, C36.2, C37.2, C39.1, C40.1, D8.1 (K), J14.6, J16.5 (GND), J16.6 (Shield), SW5.2, SW6.1, U2.3 (PE0), U2.5 (GND), U2.21 (GND), U3.7 (GND), U3.18 (GND), U3.21 (GND), U3.25 (AGND), U3.26 (TEST), U18.1 (GND); also elsewhere on the board
unnamed: R29.2, U3.1 (TXD)
unnamed: R30.2, U3.5 (RXD)

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
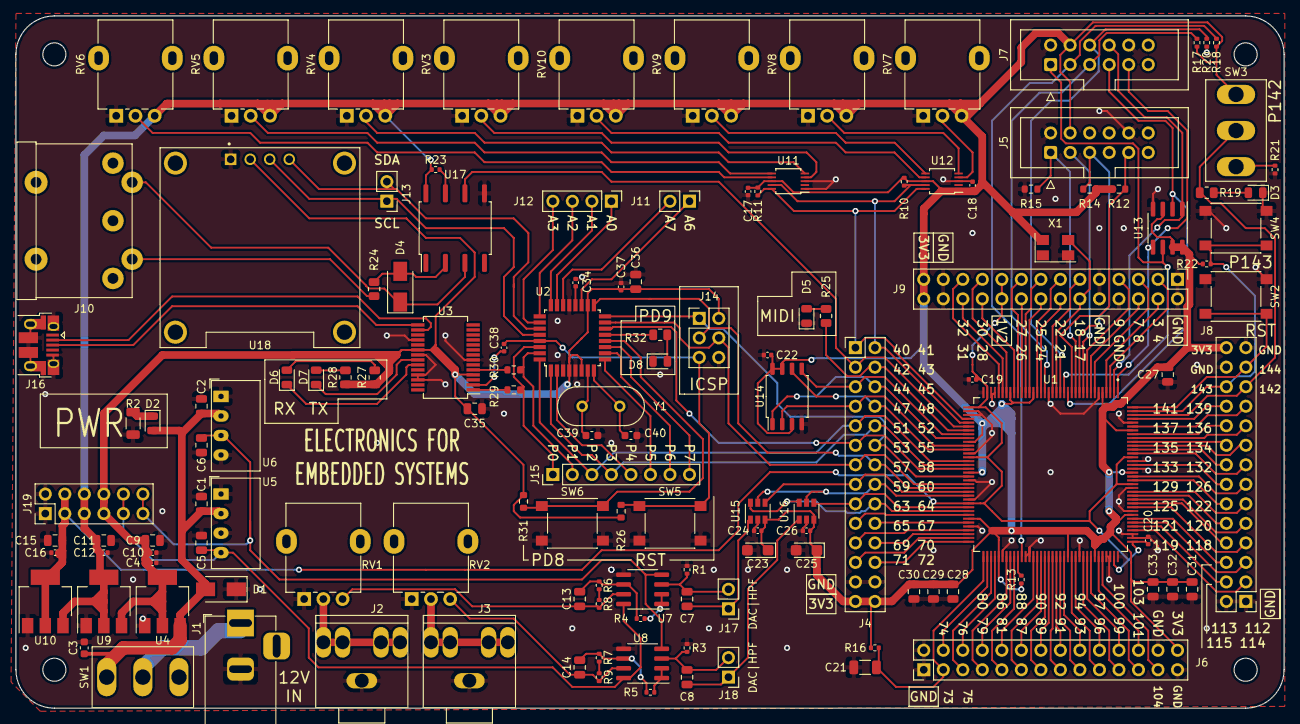
[picture p7: board EFES_project.kicad_pcb from above]

Board: 2 copper layers, 165.0 x 90.1 mm, 135 parts (0 on the bottom side), 167 nets.
