giacomogramaglia/digital_synth/RTL/MIDI_interface.vhd

library IEEE;
use IEEE.STD_LOGIC_1164.ALL;
use IEEE.STD_LOGIC_ARITH.ALL;
use IEEE.STD_LOGIC_UNSIGNED.ALL;

entity MIDI_interface is
    Port (
        clk         : in std_logic;
        reset       : in std_logic;       -- Reset button to clear received data and restart UART
        midi_rx     : in std_logic;
        frequency   : out integer range 0 to 16383;    -- Integer output frequency in Hertz
		  gate        : out std_logic);
end MIDI_interface;

architecture Behavioral of MIDI_interface is

    -- Constants
    constant MIDI_BAUD_RATE : integer := 31250;           -- Standard MIDI baud rate
    constant CLOCK_FREQ     : integer := 50000000;        -- System clock frequency (50 MHz)
    constant BIT_PERIOD     : integer := CLOCK_FREQ / MIDI_BAUD_RATE;  -- Clock cycles per MIDI bit

    -- State definitions
    type state_type is (IDLE, START, STATUS, IDLE1, START1, DATA1);
    signal state         : state_type := IDLE;

    -- Internal registers
    signal bit_count     : integer range 0 to 7 := 0;
    signal bit_timer     : integer range 0 to BIT_PERIOD - 1 := 0;
    signal shift_reg     : std_logic_vector(7 downto 0) := (others => '0');
    signal midi_note     : std_logic_vector(6 downto 0) := (others => '0');
    signal midi_note_1   : std_logic_vector(6 downto 0) := (others => '0');
	 signal gate_reg      : std_logic := '0';
	 signal timeout 		 : std_logic := '0';
	 signal start_flag	 : std_logic := '0';
	
begin
    -- Assign outputs
    gate <= gate_reg;

    -- Combined MIDI reception and processing with reset
    process(clk)
    begin
        if rising_edge(clk) then
            if reset = '0' or timeout = '1' then
                -- Clear all internal registers and set to initial values on reset
                state <= IDLE;
                bit_count <= 7;
                bit_timer <= 0;
                shift_reg <= (others => '0');
                midi_note <= (others => '0');
                gate_reg <= '0';
					 start_flag <= '0';
            else
                -- Normal operation
                case state is
                    when IDLE =>
						      start_flag <= '0';
								-- Waiting for MIDI start bit (low)
                        if midi_rx = '0' then
                            state <= START;
                            bit_timer <= BIT_PERIOD / 2;  -- Start in the middle of the start bit
                        end if;

                    when START =>
                        -- Start bit timing
                        if bit_timer = 0 then
                            state <= STATUS;
									 start_flag <= '1';
                            bit_count <= 7;
                            bit_timer <= BIT_PERIOD - 1;
                        else
                            bit_timer <= bit_timer - 1;
                        end if;

                    when STATUS =>
                        -- Shift in data bits
                        if bit_timer = 0 then
                            shift_reg(7-bit_count) <= midi_rx;
                            bit_timer <= BIT_PERIOD - 1;

                            -- If all 8 bits are received, go to stop bit
                            if bit_count = 0 then
										if shift_reg(7 downto 4) = "1000" then
                                state <= IDLE;
										  bit_count <= 7;
										  bit_timer <= BIT_PERIOD-1;  
										  gate_reg <= '0';
										
										elsif shift_reg(7 downto 4) = "1001" then
										  state <= IDLE1;
										  bit_count <= 7;
										  bit_timer <= BIT_PERIOD-1;
										  
										else
										  state <= IDLE;
										end if;
				
                            end if;
									 
									 bit_count <= bit_count - 1; 
                        else
                            bit_timer <= bit_timer - 1;
                        end if;

							when IDLE1 =>
						      start_flag <= '0';
								
								-- Waiting for MIDI start bit (low)
                        if midi_rx = '0' then
                            state <= START1;
                            bit_timer <= BIT_PERIOD / 2;  -- Start in the middle of the start bit
                        end if;
								
							when START1 =>
                        -- Start bit timing
                        if bit_timer = 0 then
                            state <= DATA1;
									 start_flag <= '1';
                            bit_count <= 7;
                            bit_timer <= BIT_PERIOD - 1;
                        else
                            bit_timer <= bit_timer - 1;
                        end if;	
								
                    when DATA1 =>
                        -- Verify stop bit and process the received byte
                        if bit_timer = 0 then
									bit_timer <= BIT_PERIOD-1;
									
									gate_reg <= '0';
									shift_reg(7-bit_count) <= midi_rx;
									
                           if bit_count = 0 then
										midi_note <= shift_reg(6 downto 0);
										gate_reg <= '1';
										state <= IDLE;
										bit_timer <= BIT_PERIOD-1;
										bit_count <= 7;
									end if;
									bit_count <= bit_count - 1; 
									
                        else
                            bit_timer <= bit_timer - 1;
                        end if;
								
                end case;
            end if;
        end if;
    end process;
	 
process(clk, start_flag) is
variable timeout_clk: integer := 0;
begin
if rising_edge(clk) then
	if start_flag = '1' then
		timeout_clk := timeout_clk + 1;
		if timeout_clk = 30*BIT_PERIOD then
			timeout_clk := 0;
			timeout <= '1';
		end if;
	else
		timeout_clk := 0;
		timeout <= '0';
	end if;
end if;
end process;	

midi_note_1 <= midi_note;


process(midi_note_1)
	begin
        case midi_note_1 is
            -- Low octave (0 to 11)
			when 	"0000000"	 => frequency <=	8	; 	-- Midi note	0
			when 	"0000001"	 => frequency <=	9	; 	-- Midi note	1
			when 	"0000010"	 => frequency <=	9	; 	-- Midi note	2
			when 	"0000011"	 => frequency <=	10	; 	-- Midi note	3
			when 	"0000100"	 => frequency <=	10	; 	-- Midi note	4
			when 	"0000101"	 => frequency <=	11	; 	-- Midi note	5
			when 	"0000110"	 => frequency <=	12	; 	-- Midi note	6
			when 	"0000111"	 => frequency <=	12	; 	-- Midi note	7
			when 	"0001000"	 => frequency <=	13	; 	-- Midi note	8
			when 	"0001001"	 => frequency <=	14	; 	-- Midi note	9
			when 	"0001010"	 => frequency <=	15	; 	-- Midi note	10
			when 	"0001011"	 => frequency <=	15	; 	-- Midi note	11
			when 	"0001100"	 => frequency <=	16	; 	-- Midi note	12
			when 	"0001101"	 => frequency <=	17	; 	-- Midi note	13
			when 	"0001110"	 => frequency <=	18	; 	-- Midi note	14
			when 	"0001111"	 => frequency <=	19	; 	-- Midi note	15
			when 	"0010000"	 => frequency <=	21	; 	-- Midi note	16
			when 	"0010001"	 => frequency <=	22	; 	-- Midi note	17
			when 	"0010010"	 => frequency <=	23	; 	-- Midi note	18
			when 	"0010011"	 => frequency <=	24	; 	-- Midi note	19
			when 	"0010100"	 => frequency <=	26	; 	-- Midi note	20
			when 	"0010101"	 => frequency <=	28	; 	-- Midi note	21
			when 	"0010110"	 => frequency <=	29	; 	-- Midi note	22
			when 	"0010111"	 => frequency <=	31	; 	-- Midi note	23
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
			when 	"1111110"	 => frequency <=	11840	; 	-- Midi note	126
			when 	"1111111"	 => frequency <=	12544	; 	-- Midi note	127		  
            when others => frequency <= 0;        -- Default case
        end case;
    end process;
	
end Behavioral;
